nkinder/smart-card-removinator/client/docs/source/index.rst

.. py:module:: removinator

Welcome to Removinator's documentation!
=======================================

Classes
=======

.. autoclass:: Removinator

Exceptions
==========

.. autoexception:: Error
.. autoexception:: CommandError
.. autoexception:: ConnectError
.. autoexception:: SlotError

Indices and tables
==================

* :ref:`genindex`
* :ref:`search`
