nkinder/smart-card-removinator/(threads)

Thread 1 (2018-03-18):

Original board KiCAD Files

andrew867, 2018-03-18:
Do you happen to still have the KiCAD design files? If so could you share them?

Thanks,
Andrew

searchmawnag, 2018-09-30:
Do you happen to still have the KiCAD design files? If so could you share them?

Thanks,
SearchMawang

Antony76, 2019-02-28:
Hi Nathan, this is a great job!
I am interested in KiCAD project as well. Specially for the smart card adapter you made.
Thank you in advance,
Antony

sabas1080, 2019-10-29:
@nkinder Do you happen to still have the KiCAD design files? If so could you share them?

nkinder, 2019-10-30:
Hi everyone.  I didn't use KiCAD to create the design unfortunately.  I used the ExpressPCB software (free, but not open-source) since they did my PCB printing.
