nkinder/smart-card-removinator/(commit log)

2016-10-14 Add electrical schematics
    This adds SVGs of the electrical schematics and updates the README
    to add some basic descriptions and to disaplay inline copies of
    the images.
2016-10-14 Add controller firmware
    This adds the source code for the controller firmware. It can be
    updated to the controller via the Arduino IDE.
2016-10-14 Fix typos in firmware comments.
    [removinator.ino]
2016-10-15 Add controller PCB files
    This adds Gerber RS-274-X for both controller PCBs and describes
    which files are for which layers in the README.
2016-10-15 Add card reader adapter schematic
    This adds a SVG schematic for the card reader adapter and also
    updates the README to display a copy of it.
2016-10-16 Add card reader adapter PCB files
    This adds Gerber files for the card reader adapter and updates the
    README to provide info and a rendering of the PCB design.
    [card_reader_adapter.drl]
2016-10-17 Correct location of contacts on card adapter
    The ISO 7816 contacts on the card reader adapter were slightly
    shifted to one side. This corrects the Gerber files to shift
    them over to the correct location. For consistency, all layers
    were regenerated.
    [card_reader_adapter.drl]
2016-10-19 Move firmware to a subdirectory to allow compilation
    The Arduino IDE requires a sketch file to exist in a directory
    with the same name (minus the .ino extension). This patch creates
    the proper directory structure to allow compilation from the IDE.
2016-10-19 Correct card detection logic
    The card detection logic was reversed, causign the STA command to
    return incorrect results, and also preventing a populated card
    slot from being selected. This patch flips the status bit before
    it is returned when we parse the byte that is returned from the
    shift register.
    [removinator.ino]
2016-10-19 Correct display segment bits
    The mapping of bits to specific segments of the display changed
    from the prototype circuit when the PCB design was created. This
    corrects the mapping so the display works properly for the circuit
    shown in the schematic and the PCB design.
    [removinator.ino]
2016-10-20 Add enclosure details
    This adds a SVG for an enclosure for the controller. It also updates
    the README to add details and parts related to the enclosure.
2016-10-20 Clean up card reader adapter gerber files
    This cleans up the traces on the care reader adapter to have better
    spacing. It also adds a board version number and name to the silk
    screen layer.
    [card_reader_adapter.drl]
2016-10-20 Update enclosure SVG page area
    The enclosure drawing was not in the SVG page area, which prevented
    it from being rendered when browsing it in the github UI. This
    corrects the SVG page area.
2016-10-20 Add pictures of assembled controller
    This adds pictures of an assembled controller to the README.
2016-10-21 Update controller board A gerber files to v1.01
    The PCB design for board A of the controller had the pins
    of the Arduino socket rotated such that the USB port pointed
    forward instead of towards the back of the unit. This adds
    a new revision of the board A design that corrects the
    orientation of the Arduino socket. To distinguish between
    the board revisions, a v1.01 indicator has been added to the
    silk screen layer.
2016-11-02 Correct hole locations for enclosure
    The hole locations for the enclosure base/top plate design did not
    patch up with the PCB hole locations. This corrects the layout so
    everything lines up properly.
2016-11-03 Add reader switch control support to firmware
    Most card readers have an internal switch that detects the
    physical presence of a card without using the card contacts.
    This switch is used by smart card reader drivers to detect
    insertion and removal events. In order to trigger these
    events when we virtually switch a card, we need to control
    the reader switch state from the firmware even though the
    card reader adapter remains inserted.
    This patch adds control of a digital output pin that is cycled
    when we remove a card as well as when we switch between two card
    slots. This requires this pin to be connected to a modified
    reader. These modifications will be described in the README in
    a later p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
2016-11-04 Add details about card reader modification
    This adds a description of the card reader modifications that are
    needed to the README. A schematic of the modifications is also
    added to the schematics directory.
2016-11-04 Allow serial response to be supressed for removeCard function
    Now that the removeCard() function is called internally, we need
    to be able to supress printing the result output to the serial port
    to prevent spurious responses.
    [removinator.ino]
2016-11-04 Add OMNIKEY 3121 modification details
    This adds details and images to the README for modifying an
    OMNIKEY 3121 smart card reader to have its card presence switch
    controlled by the removinator controller.
2016-11-05 Update card reader modification to not include a ground wire
    Connecting a ground wire between the controller and the card reader
    produces a ground loop, which could potentially introduce interference.
    Since the card reader and the controller are both powered by the same
    computer over USB, they already share a common ground. Thus, there is
    no need for an additional ground wire. This updates the README file
    to not mention anything about adding a ground wire.
2016-11-08 Add enclosure image and details to README
    This adds an image of a completed controller in an enclosure along
    with details on the components required to build the enclosure.
2016-11-10 Add Python client module
    This adds a Python client module that allows the Removinator
    controller to be controlled via a Python program. In addition to
    the module itself, this includes everything needed for building
    a source distribution and a wheel as well as sphinx docs.
2017-01-30 Correct typo in comment in firmware source
    [removinator.ino]
2017-01-30 Correct parsing of DBG command response in client library
    The removinator client library was incorrectly parsing the response
    of the DBG command. This could cause the debug toggle to be left in
    the incorrect state when the debug toggle is already on and the client
    library is used to turn on the debugging toggle again.
    [removinator.py]
2017-01-30 Correct typo in "unknown command" error response
    The "unknown command" error response had a typo in both the README
    and the firmware. This corrects the error response.
    [removinator.ino]
2020-06-06 python3 subprocess encoding fix
    the subprocess check_output calls were returning binary output in some
    cases. This change just forces utf-8 encoding for those two calls.
    [removinator.py]
2024-09-13 Use std C data types instead of Arduino-specific ones
2024-09-13 Add card slot locking functionality to the firmware
